vedantjh2/robotic-arm/docs/purchased_hardware_A1.csv

item | quantity | selection_notes
XC330-class compact smart motor | 8 | 20 x 34 x 26 mm verified envelope; final model and duty torque to verify
Matching supplier output horn | 8 | Stock horn plus supplier-matched adapter; CAD bolt pattern provisional
Retained steel finger pin or shoulder bolt 3 mm | 14 | Nominal span 22 mm; determine shoulder and retention lengths
Thumb shoulder axle 5 mm | 1 | Length and washer stack from final thumb assembly
Wrist flexion steel D shaft 5 mm | 1 | Flat at 2 mm from center; nominal modeled span 65 mm; validate hub clamp and retention
Wrist deviation shoulder axle 5 mm | 1 | Nominal modeled span 26 mm; determine thrust washer stack
Wrist flexion bushings 5 mm ID 8 mm OD 8 mm long | 2 | Press/slip fit appropriate to print process; CAD fork bore 8.2 mm
Wrist deviation bushing 5 mm ID 8 mm OD 8 mm long | 1 | Match carpal gimbal bore and shaft fit
Thrust washers and axle keepers | 1 set | Must constrain axial motion without clamping moving parts
M6 cable barrel adjuster with locking nuts | 6 | Finger and thumb-opposition sheath termination on moving palm; confirm ferrule and tube compatibility
Wrist moving-frame sheath ferrules and adjusters | 4 | Two opposed pairs; one set terminates on fixed fork, deviation pair on moving gimbal
Braided UHMWPE tendon approximately 0.8 mm | 1 spool | Supplier load specification knot derating abrasion and creep to validate
PTFE-lined sheath approximately 3 mm OD | 10 runs | 6 hand tendons plus 4 wrist antagonist strands; final ID and bend radius to select
Elastic finger and thumb returns | 15 | 14 flexion joints plus thumb opposition; stiffness and pretension from bench test
Compliant motor seat/shim | 8 | Prevents clamp creep and case damage; verify compressed thickness
M2.5 clamp screws or process-matched inserts | 32 | Sixteen clamps with two screws each; verify modeled post bores
M3 palm/root/anchor/shell fasteners | 1 set | Lengths and captive access to derive from final hardware stack
M4 rail attachment fasteners | 4 | Captive nut or insert detail required for hollow rail ends
M6 proximal mounting fasteners | 4 | Bench fixture and flange load rating to check
M3 shaft set screws | 3 | Two gimbal and one external sector; process-matched threads/inserts and locking method
TPU or silicone contact pads | 5 | Five modeled fingertip pads; optional further phalanx pads
5 V-class regulated motor supply and branch protection | 1 set | XC330 reference is 3.7-6 V recommended 5 V; measured-duty and transient sizing required
TTL motor interface and local controller | 1 set | Deterministic limits current sensing watchdog hard power disconnect; VLM offboard
