vedantjh2/robotic-arm/output/A1/assembly/anatomy_tendon_hand_A1.step

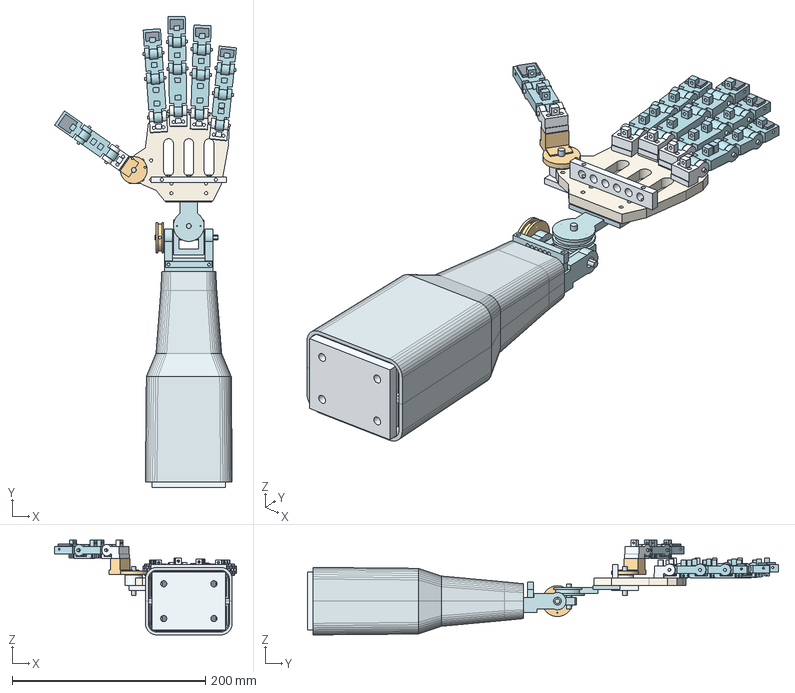
[picture p1: CAD file, 2026-09-28]
output/A1/assembly/anatomy_tendon_hand_A1.step
188.6 x 488.1 x 98.3 mm
Proximal_actuator_cassette
Radius_inspired_rail
Ulna_inspired_rail
Distal_retinaculum
Dorsal_forearm_shell
Palmar_forearm_shell
Radiocarpal_fork
Carpal_gimbal
Wrist_flexion_sector
Carpal_hand_carrier
Metacarpal_frame
Palmar_tendon_anchor
index_root
index_phalanx_1
index_hinge_pin_1
index_phalanx_2
index_hinge_pin_2
index_phalanx_3
index_hinge_pin_3
index_contact_pad
middle_root
middle_phalanx_1
middle_hinge_pin_1
middle_phalanx_2
middle_hinge_pin_2
middle_phalanx_3
middle_hinge_pin_3
middle_contact_pad
ring_root
ring_phalanx_1
ring_hinge_pin_1
ring_phalanx_2
ring_hinge_pin_2
ring_phalanx_3
ring_hinge_pin_3
ring_contact_pad
little_root
little_phalanx_1
little_hinge_pin_1
little_phalanx_2
little_hinge_pin_2
little_phalanx_3
little_hinge_pin_3
little_contact_pad
thumb_root
thumb_phalanx_1
thumb_hinge_pin_1
thumb_phalanx_2
thumb_hinge_pin_2
thumb_contact_pad
Thumb_pivot_housing
Thumb_opposition_carrier
Thumb_pivot_axle
flexion_axle
deviation_axle
Motor_M1
Spool_M1
M1_clamp_-13
M1_clamp_-3
Motor_M2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
