vedantjh2/robotic-arm/output/A1/parts/wrist_flexion_sector.step

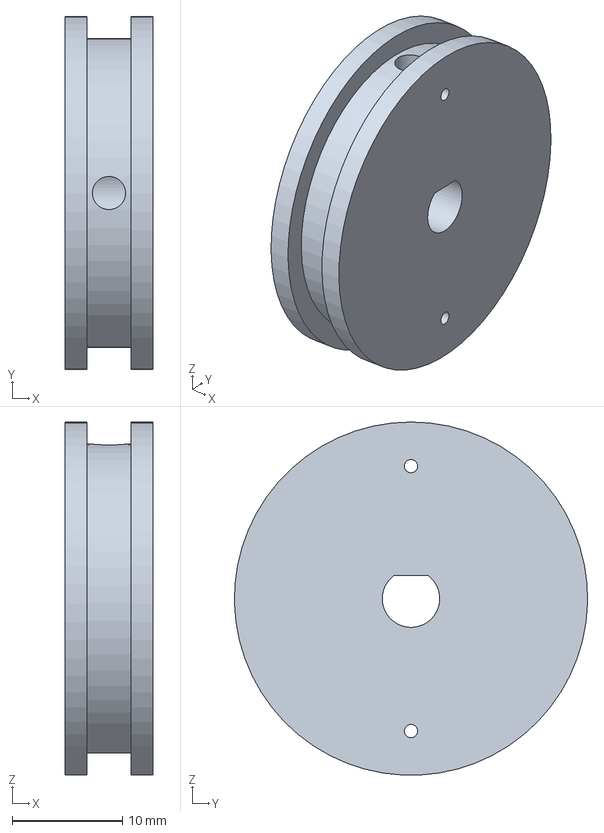
[picture p2: CAD file, 2026-09-28]
output/A1/parts/wrist_flexion_sector.step
8.00 x 32.0 x 32.0 mm
