vedantjh2/robotic-arm/output/assembly/tendon_hand_A0.step

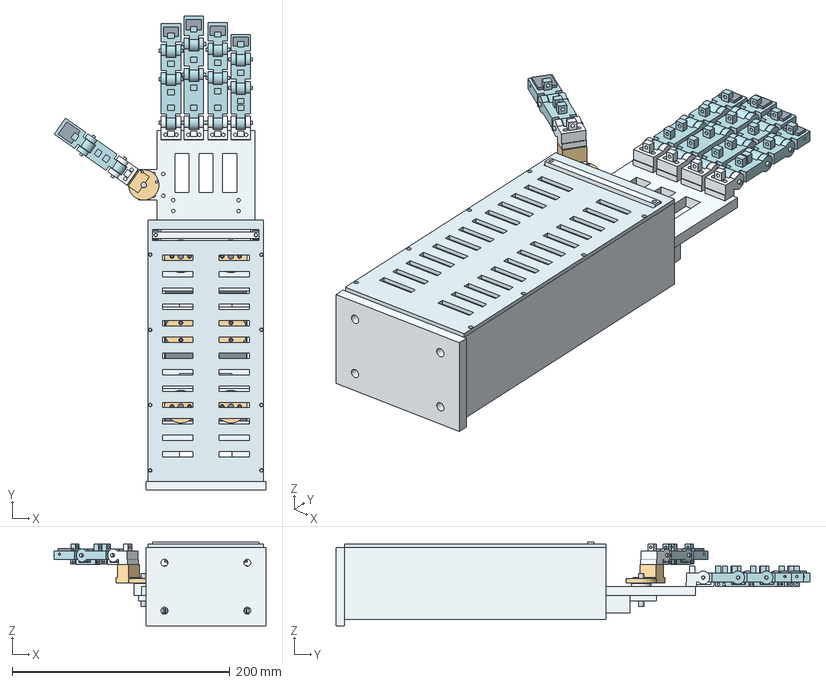
[picture p3: CAD file, 2026-09-28]
output/assembly/tendon_hand_A0.step
194.2 x 435.0 x 77.0 mm
Forearm_chassis
Wrist_bridge
Palm_frame
Forearm_cover
Sheath_comb_1
Sheath_comb_2
Adjustable_sheath_anchor
Motor_M1
Spool_M1
M1_clamp_-18
M1_clamp_-6
Motor_M2
Spool_M2
M2_clamp_-18
M2_clamp_-6
Motor_M3
Spool_M3
M3_clamp_-18
M3_clamp_-6
Motor_M4
Spool_M4
M4_clamp_-18
M4_clamp_-6
Motor_M5
Spool_M5
M5_clamp_-18
M5_clamp_-6
Motor_M6
Spool_M6
M6_clamp_-18
M6_clamp_-6
index_root
index_phalanx_1
index_hinge_pin_1
index_phalanx_2
index_hinge_pin_2
index_phalanx_3
index_hinge_pin_3
index_contact_pad
middle_root
middle_phalanx_1
middle_hinge_pin_1
middle_phalanx_2
middle_hinge_pin_2
middle_phalanx_3
middle_hinge_pin_3
middle_contact_pad
ring_root
ring_phalanx_1
ring_hinge_pin_1
ring_phalanx_2
ring_hinge_pin_2
ring_phalanx_3
ring_hinge_pin_3
ring_contact_pad
little_root
little_phalanx_1
little_hinge_pin_1
little_phalanx_2
little_hinge_pin_2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
