vedantjh2/robotic-arm/output/parts/bowden_anchor.step

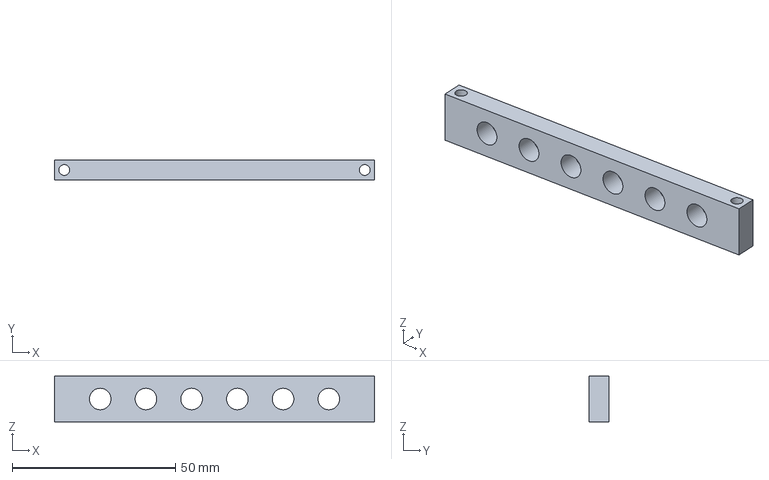
[picture p4: CAD file, 2026-09-28]
output/parts/bowden_anchor.step
98.0 x 6.00 x 14.0 mm
