vedantjh2/robotic-arm/output/A1/parts/index_3.step

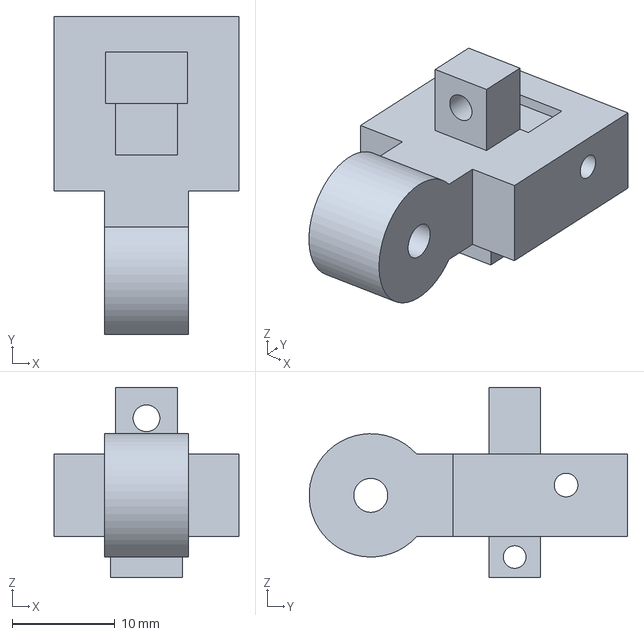
[picture p5: CAD file, 2026-09-28]
output/A1/parts/index_3.step
18.0 x 31.0 x 18.5 mm
