vedantjh2/robotic-arm/output/parts/palm_frame.step

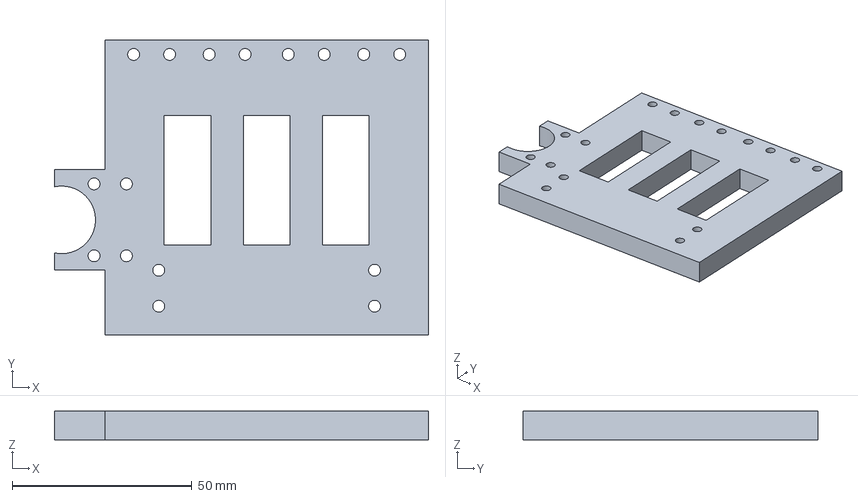
[picture p6: CAD file, 2026-09-28]
output/parts/palm_frame.step
104.0 x 82.0 x 8.00 mm
