vedantjh2/robotic-arm/output/A1/parts/index_1.step

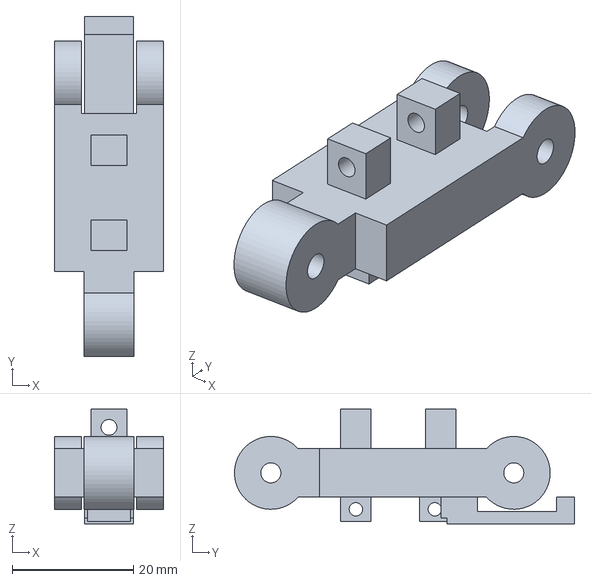
[picture p7: CAD file, 2026-09-28]
output/A1/parts/index_1.step
18.0 x 56.0 x 18.9 mm
