vedantjh2/robotic-arm/output/parts/ring_2.step

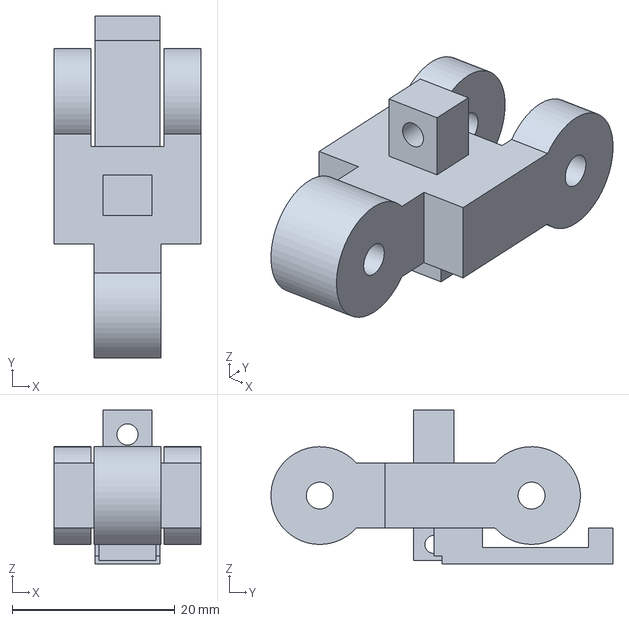
[picture p8: CAD file, 2026-09-28]
output/parts/ring_2.step
18.0 x 42.0 x 18.9 mm
