vedantjh2/robotic-arm/output/A1/parts/thumb_1.step

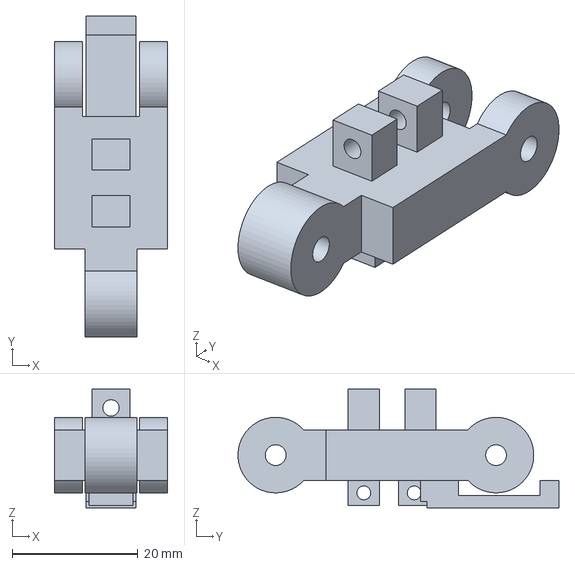
[picture p9: CAD file, 2026-09-28]
output/A1/parts/thumb_1.step
18.0 x 51.0 x 18.9 mm
