vedantjh2/robotic-arm/output/parts/fit_coupon.step

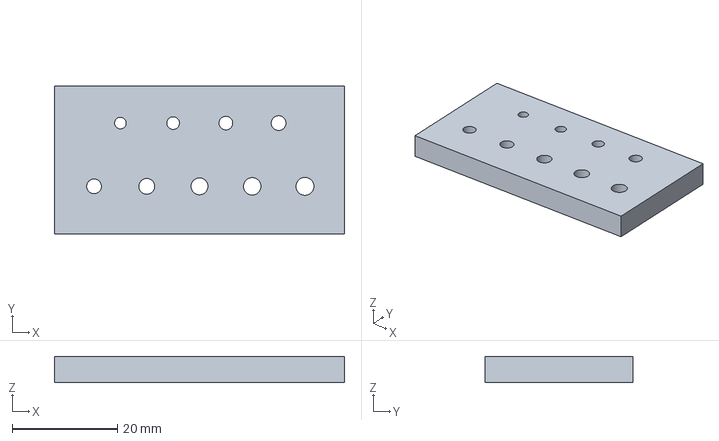
[picture p10: CAD file, 2026-09-28]
output/parts/fit_coupon.step
55.0 x 28.0 x 5.00 mm
