vedantjh2/robotic-arm/output/A1/parts/tendon_retinaculum.step

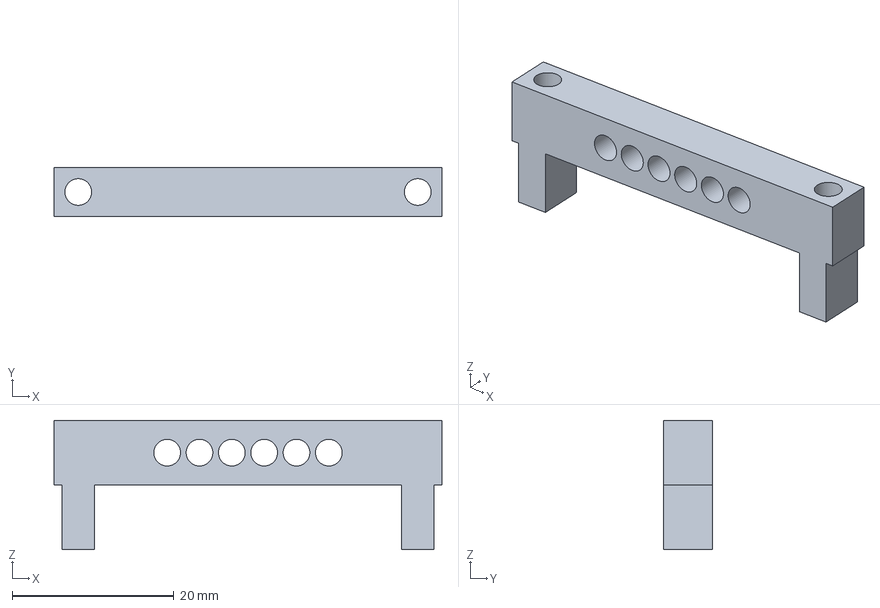
[picture p11: CAD file, 2026-09-28]
output/A1/parts/tendon_retinaculum.step
48.0 x 6.00 x 16.0 mm
