vedantjh2/robotic-arm/output/parts/little_pad.step

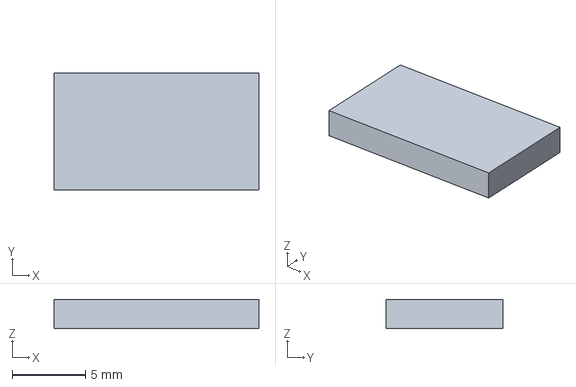
[picture p12: CAD file, 2026-09-28]
output/parts/little_pad.step
14.0 x 8.00 x 2.00 mm
