vedantjh2/robotic-arm/output/A1/parts/palmar_shell.step

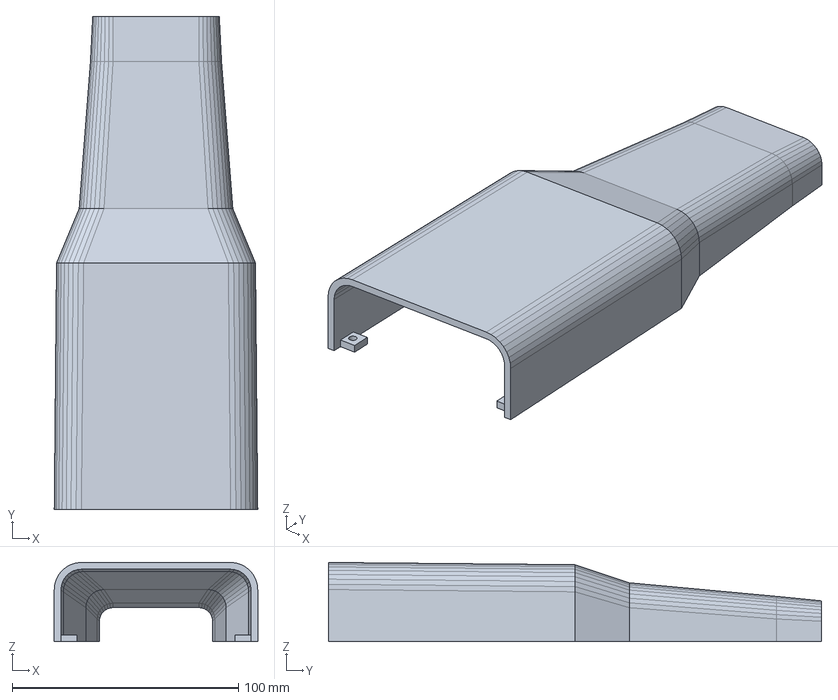
[picture p13: CAD file, 2026-09-28]
output/A1/parts/palmar_shell.step
90.0 x 218.0 x 35.0 mm
