vedantjh2/robotic-arm/output/parts/little_3.step

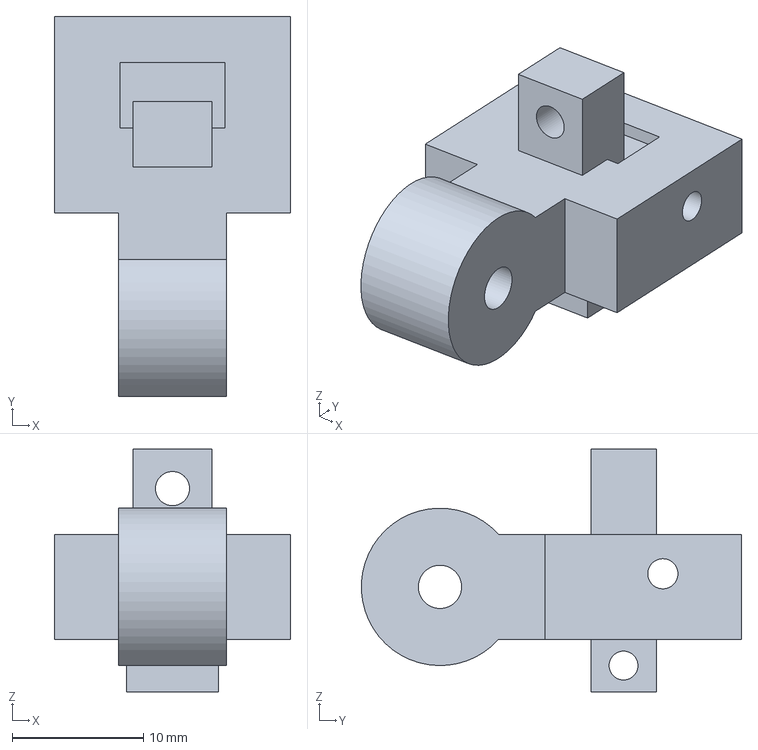
[picture p14: CAD file, 2026-09-28]
output/parts/little_3.step
18.0 x 29.0 x 18.5 mm
