vedantjh2/robotic-arm/output/parts/middle_3.step

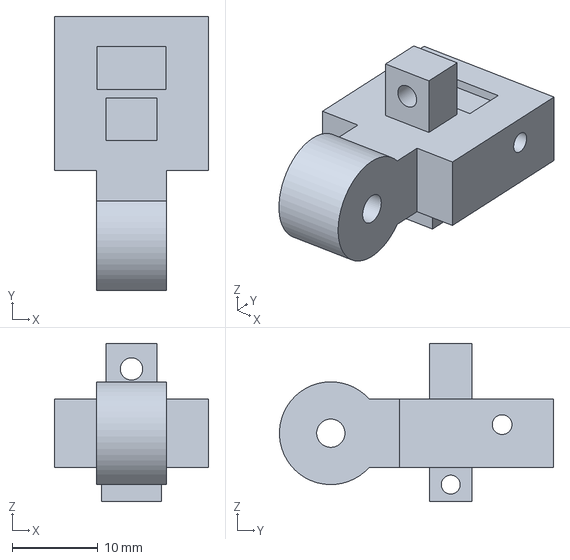
[picture p15: CAD file, 2026-09-28]
output/parts/middle_3.step
18.0 x 32.0 x 18.5 mm
