vedantjh2/robotic-arm/output/A1/parts/metacarpal_frame.step

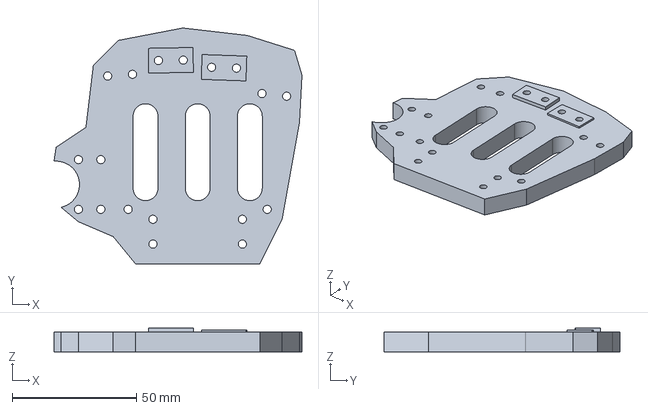
[picture p16: CAD file, 2026-09-28]
output/A1/parts/metacarpal_frame.step
99.8 x 95.0 x 9.60 mm
