vedantjh2/robotic-arm/output/parts/middle_1.step

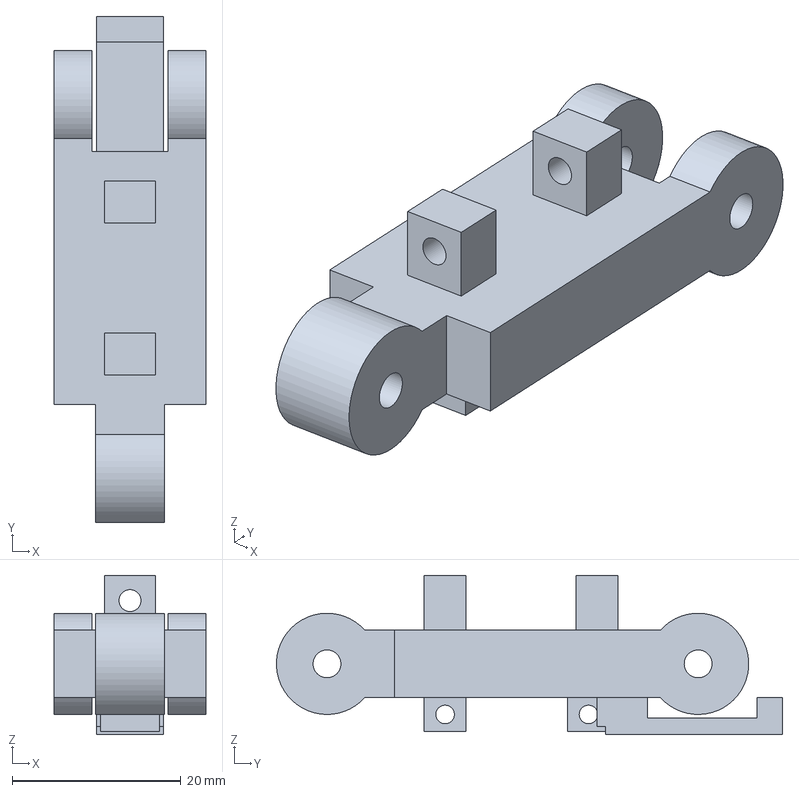
[picture p17: CAD file, 2026-09-28]
output/parts/middle_1.step
18.0 x 60.0 x 18.9 mm
