vedantjh2/robotic-arm/output/A1/parts/ulna_rail.step

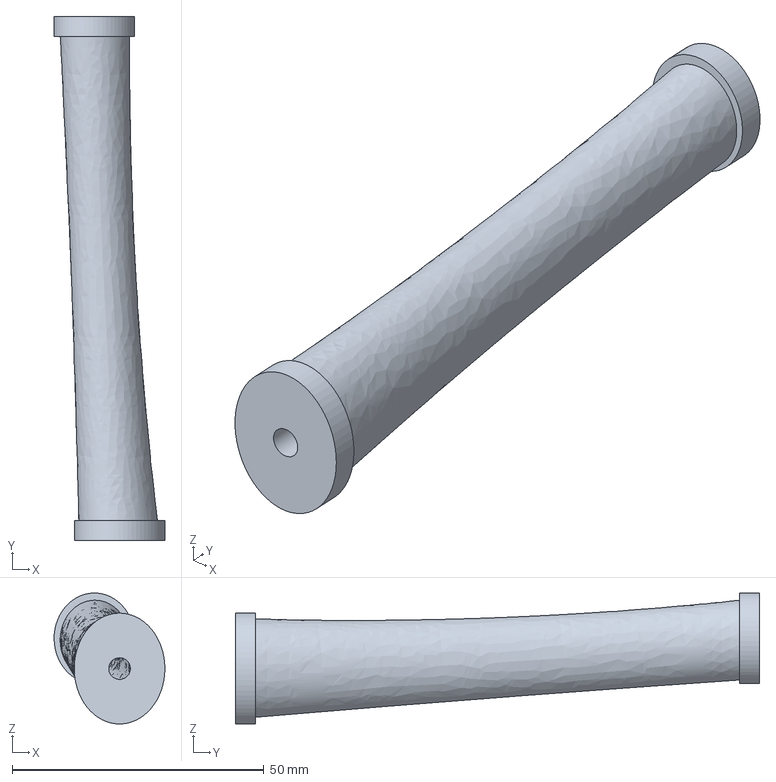
[picture p18: CAD file, 2026-09-28]
output/A1/parts/ulna_rail.step
22.0 x 104.0 x 26.0 mm
