vedantjh2/robotic-arm/output/parts/thumb_2.step

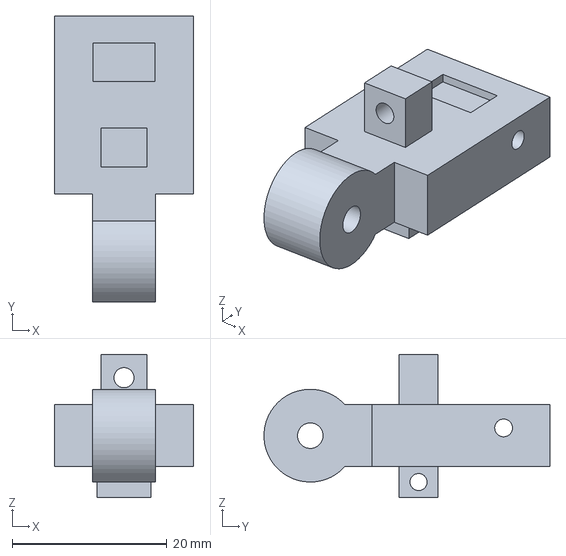
[picture p19: CAD file, 2026-09-28]
output/parts/thumb_2.step
18.0 x 37.0 x 18.5 mm
