vedantjh2/robotic-arm/output/A1/parts/index_pad.step

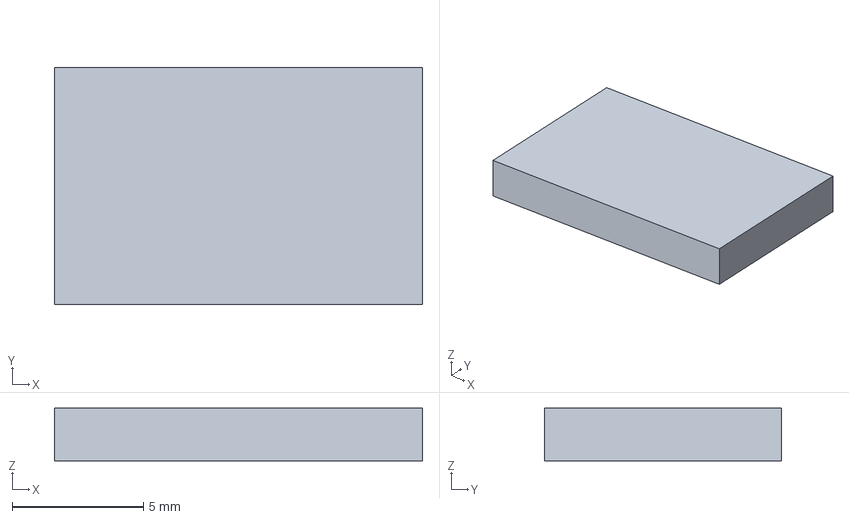
[picture p20: CAD file, 2026-09-28]
output/A1/parts/index_pad.step
14.0 x 9.00 x 2.00 mm
