vedantjh2/robotic-arm/output/parts/bowden_comb.step

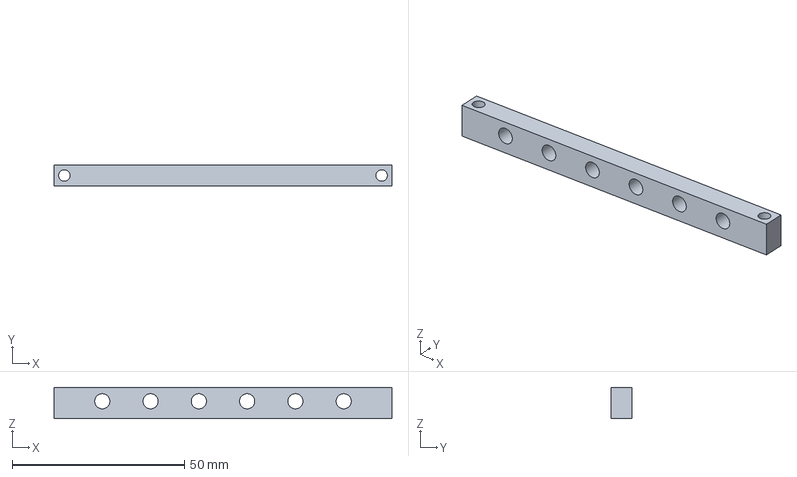
[picture p21: CAD file, 2026-09-28]
output/parts/bowden_comb.step
98.0 x 6.00 x 9.00 mm
