vedantjh2/robotic-arm/output/parts/thumb_opposition_carrier.step

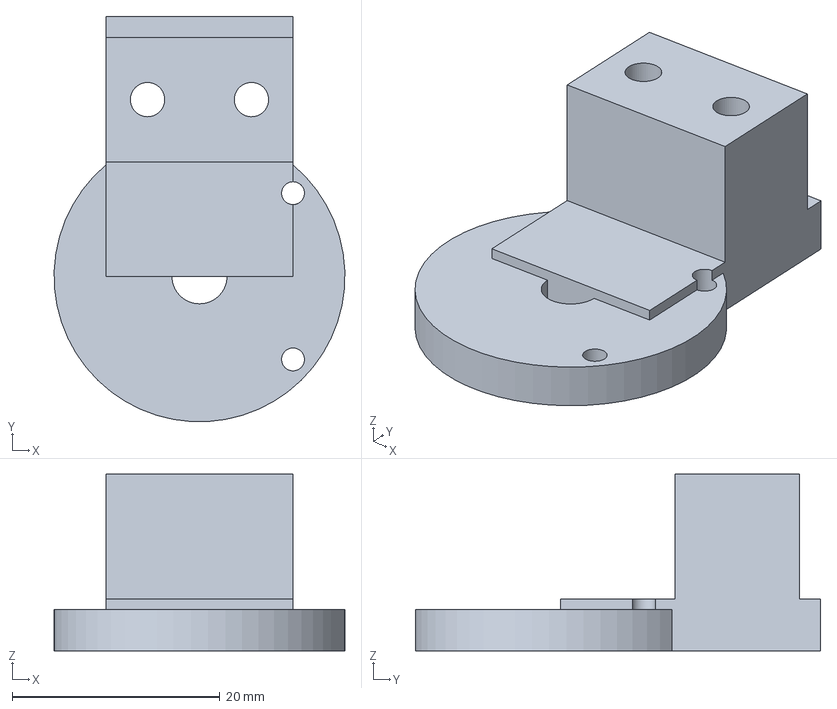
[picture p22: CAD file, 2026-09-28]
output/parts/thumb_opposition_carrier.step
28.0 x 39.0 x 17.0 mm
