vedantjh2/robotic-arm/output/A1/parts/micro_servo_clamp.step

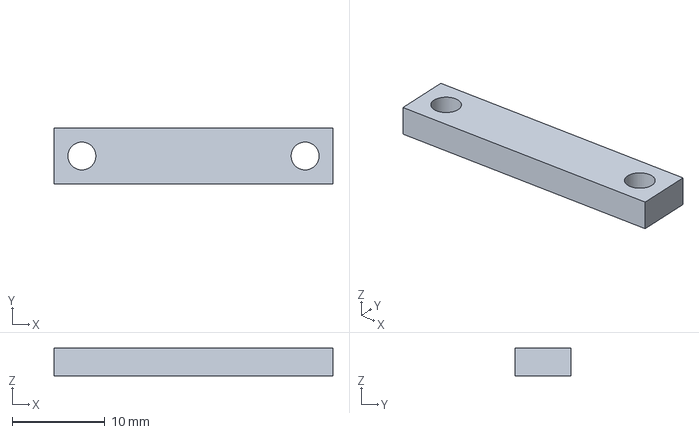
[picture p23: CAD file, 2026-09-28]
output/A1/parts/micro_servo_clamp.step
30.0 x 6.00 x 3.00 mm
