vedantjh2/robotic-arm/output/parts/motor_clamp.step

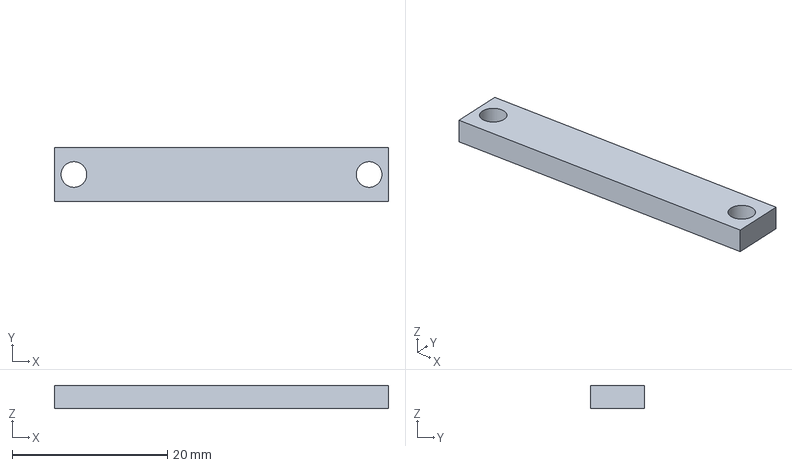
[picture p24: CAD file, 2026-09-28]
output/parts/motor_clamp.step
43.0 x 7.00 x 3.00 mm
