vedantjh2/robotic-arm/output/parts/middle_2.step

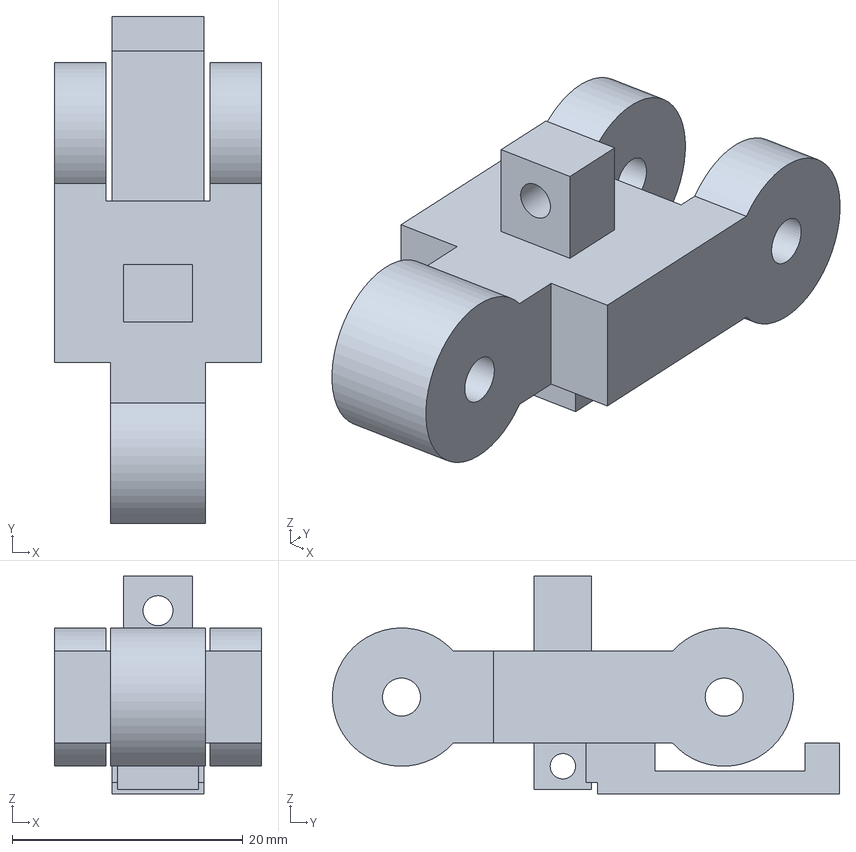
[picture p25: CAD file, 2026-09-28]
output/parts/middle_2.step
18.0 x 44.0 x 18.9 mm
