vedantjh2/robotic-arm/output/A1/parts/middle_pad.step

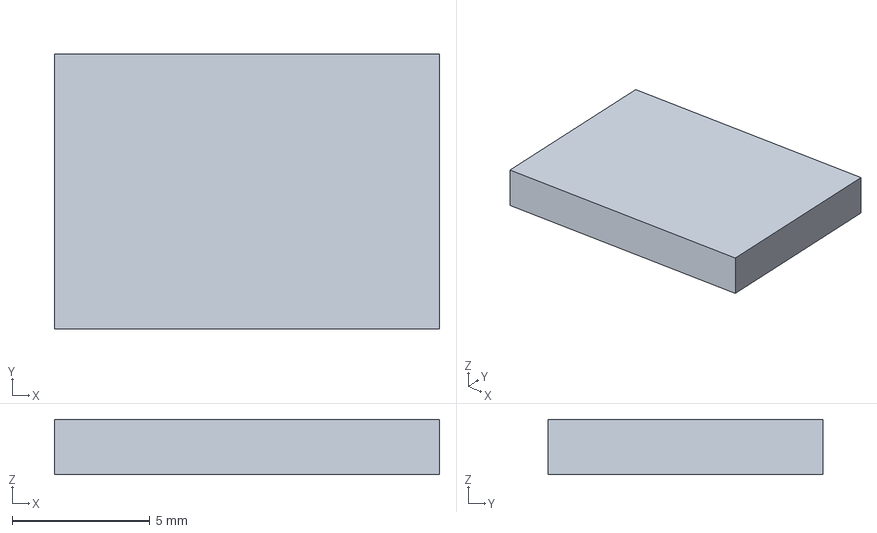
[picture p26: CAD file, 2026-09-28]
output/A1/parts/middle_pad.step
14.0 x 10.0 x 2.00 mm
