vedantjh2/robotic-arm/output/parts/ring_1.step

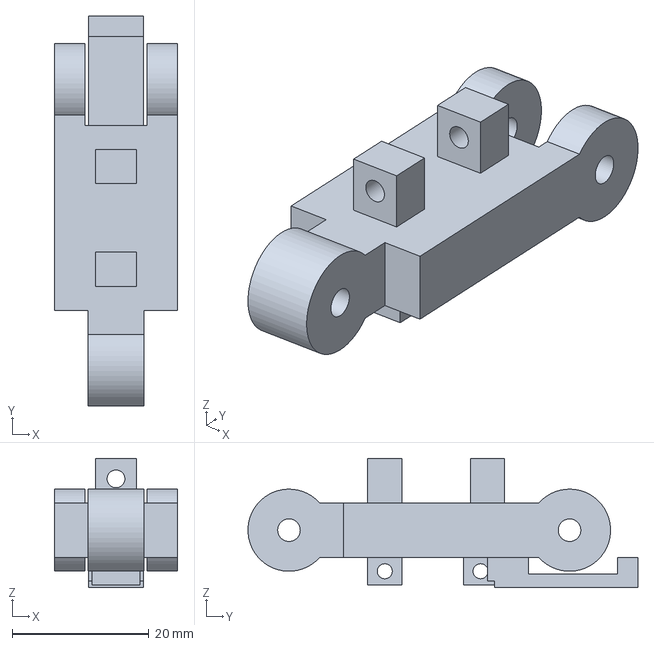
[picture p27: CAD file, 2026-09-28]
output/parts/ring_1.step
18.0 x 57.0 x 18.9 mm
