vedantjh2/robotic-arm/output/parts/tendon_spool.step

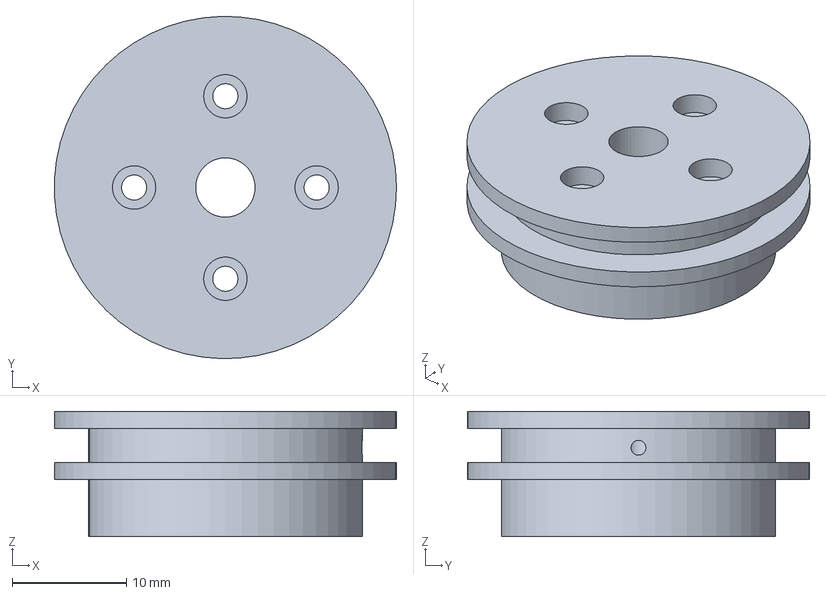
[picture p29: CAD file, 2026-09-28]
output/parts/tendon_spool.step
30.0 x 30.0 x 11.0 mm
