vedantjh2/robotic-arm/output/parts/forearm_cover.step

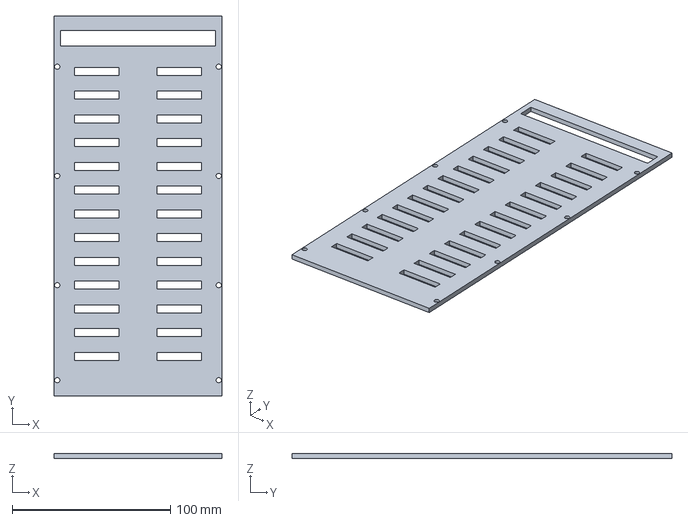
[picture p30: CAD file, 2026-09-28]
output/parts/forearm_cover.step
106.0 x 240.0 x 3.00 mm
