vedantjh2/robotic-arm/output/A1/parts/carpal_hand_carrier.step

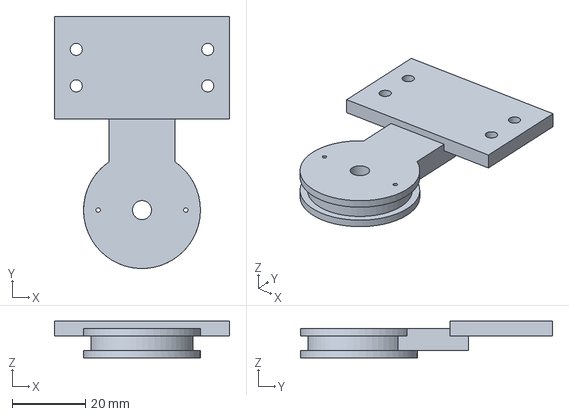
[picture p31: CAD file, 2026-09-28]
output/A1/parts/carpal_hand_carrier.step
48.0 x 69.0 x 10.0 mm
