vedantjh2/robotic-arm/output/parts/forearm_chassis.step

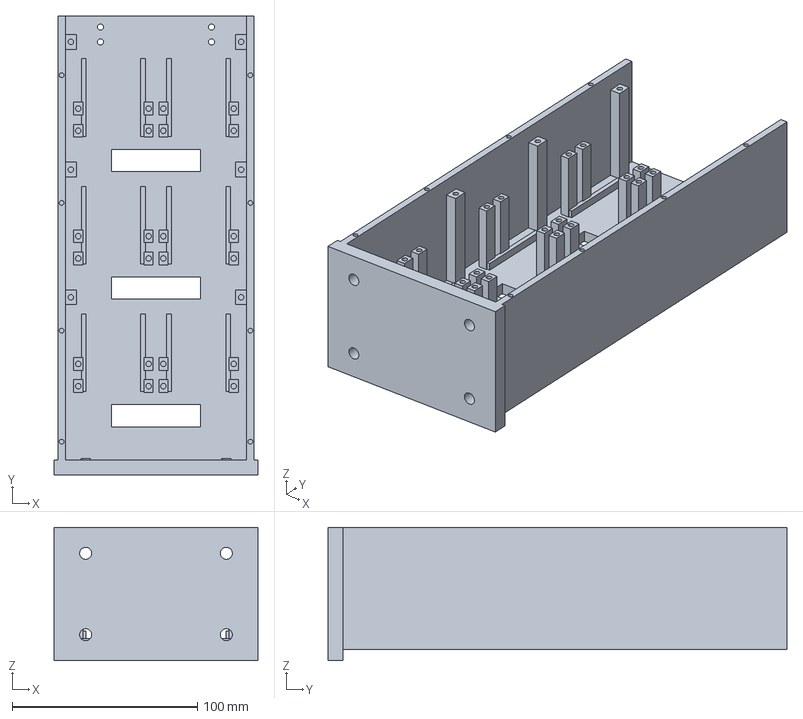
[picture p32: CAD file, 2026-09-28]
output/parts/forearm_chassis.step
110.0 x 248.0 x 72.0 mm
