vedantjh2/robotic-arm/output/A1/parts/proximal_motor_cassette.step

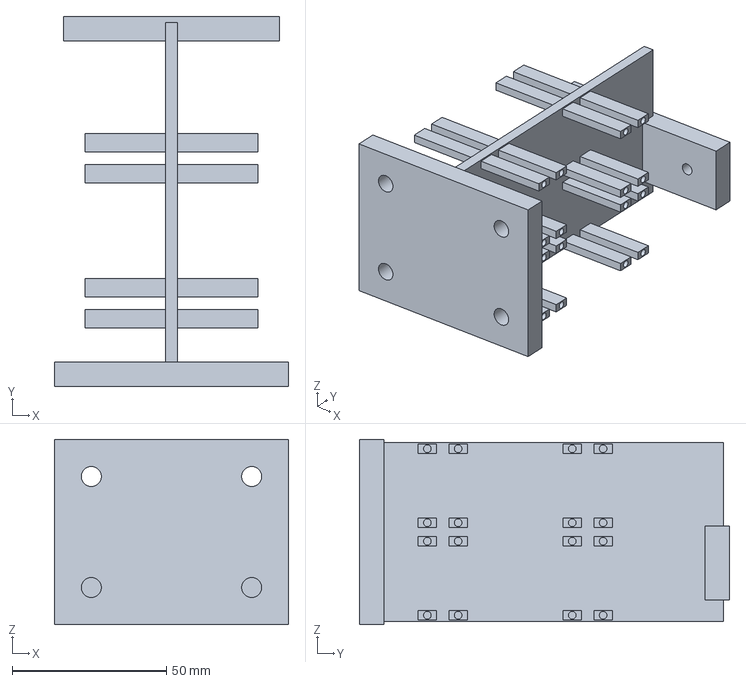
[picture p33: CAD file, 2026-09-28]
output/A1/parts/proximal_motor_cassette.step
76.0 x 120.0 x 60.0 mm
