vedantjh2/robotic-arm/output/parts/thumb_pivot_base.step

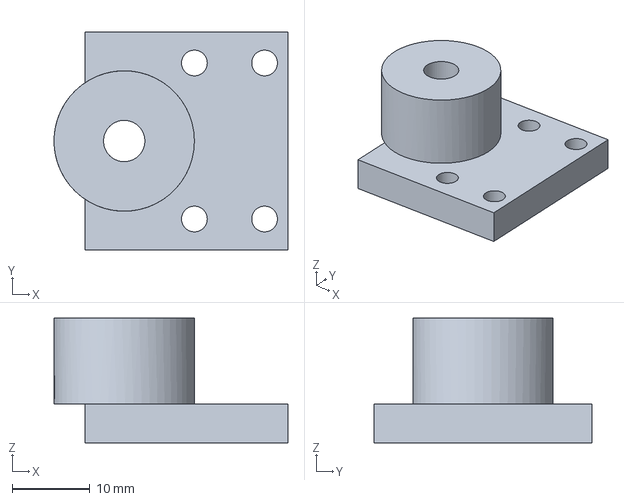
[picture p34: CAD file, 2026-09-28]
output/parts/thumb_pivot_base.step
30.0 x 28.0 x 16.0 mm
