vedantjh2/robotic-arm/output/parts/thumb_pad.step

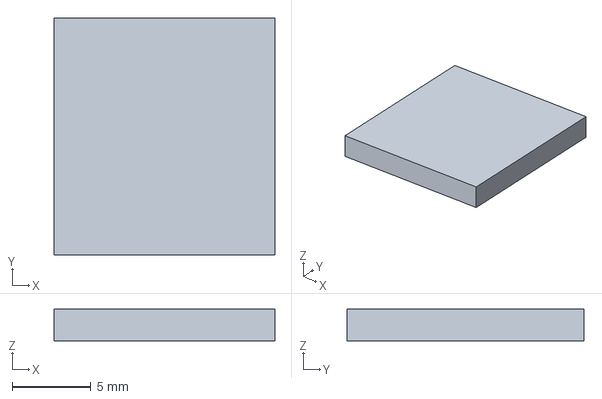
[picture p35: CAD file, 2026-09-28]
output/parts/thumb_pad.step
14.0 x 15.0 x 2.00 mm
