vedantjh2/robotic-arm/output/A1/parts/mcp_root.step

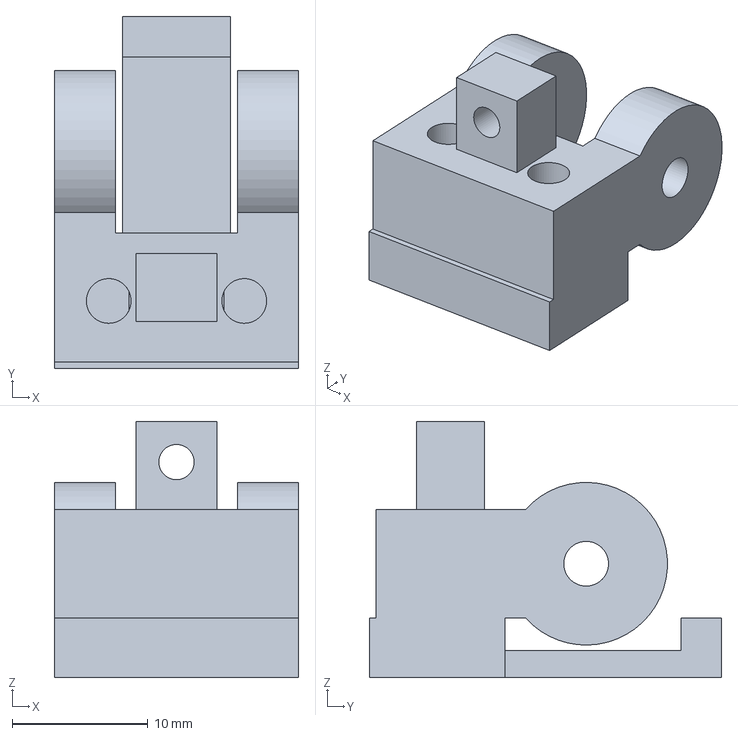
[picture p36: CAD file, 2026-09-28]
output/A1/parts/mcp_root.step
18.0 x 26.0 x 18.9 mm
