vedantjh2/robotic-arm/output/parts/fixed_wrist_bridge.step

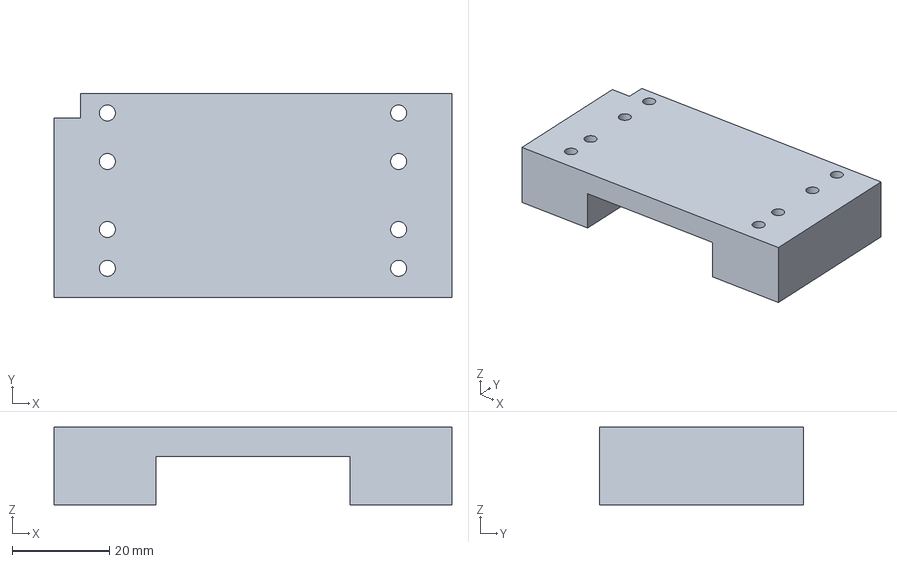
[picture p37: CAD file, 2026-09-28]
output/parts/fixed_wrist_bridge.step
82.0 x 42.0 x 16.0 mm
