vedantjh2/robotic-arm/output/A1/parts/micro_tendon_spool.step

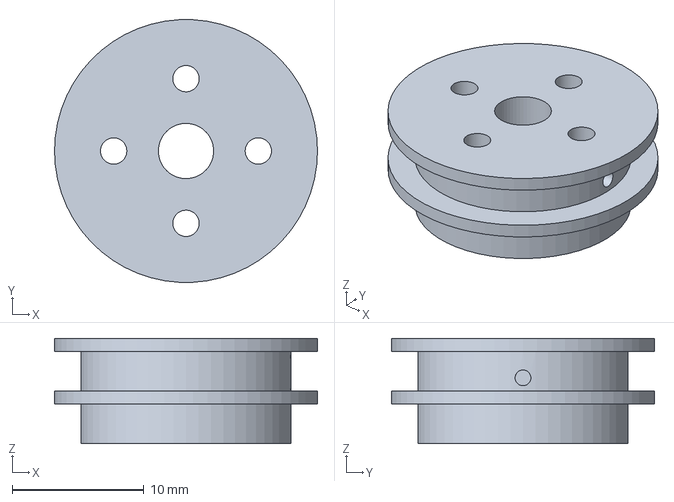
[picture p39: CAD file, 2026-09-28]
output/A1/parts/micro_tendon_spool.step
20.0 x 20.0 x 8.00 mm
