vedantjh2/robotic-arm/output/A1/parts/palmar_bowden_anchor.step

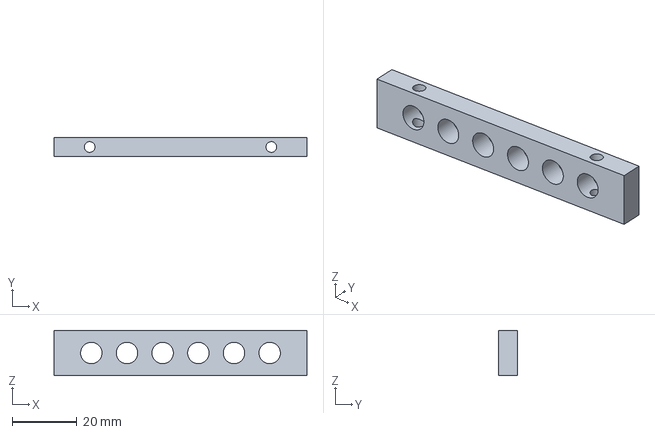
[picture p40: CAD file, 2026-09-28]
output/A1/parts/palmar_bowden_anchor.step
78.0 x 6.00 x 14.0 mm
