vedantjh2/robotic-arm/output/A1/parts/radiocarpal_fork.step

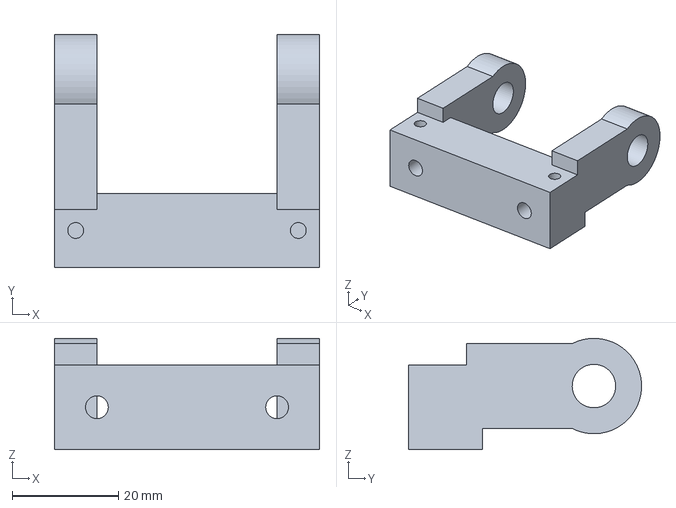
[picture p41: CAD file, 2026-09-28]
output/A1/parts/radiocarpal_fork.step
50.0 x 44.0 x 21.0 mm
