vedantjh2/robotic-arm/output/A1/parts/carpal_gimbal.step

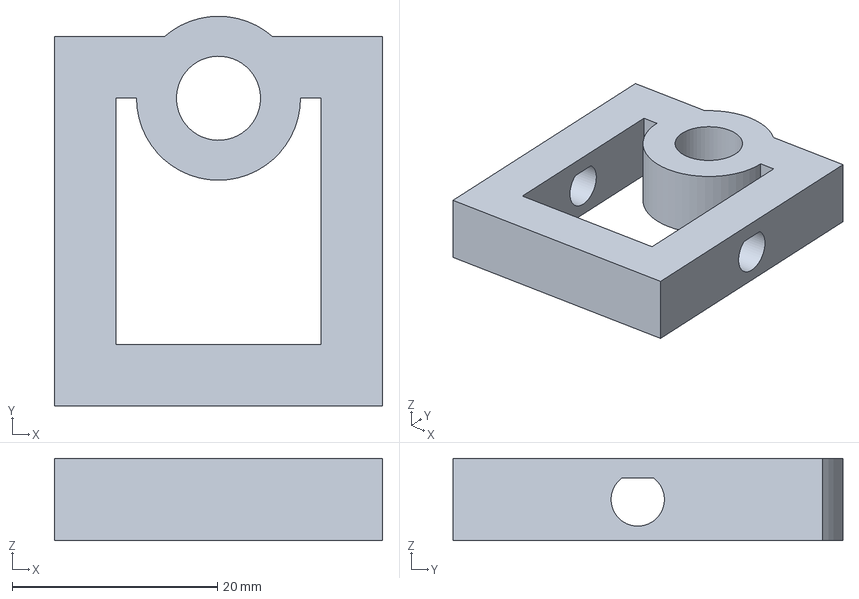
[picture p42: CAD file, 2026-09-28]
output/A1/parts/carpal_gimbal.step
32.0 x 38.0 x 8.00 mm
