vedantjh2/robotic-arm/(list of files, cad)

Other CAD files:
output/A1/parts/dorsal_shell.step
output/A1/parts/middle_3.step
output/parts/thumb_1.step
output/A1/parts/little_pad.step
output/A1/parts/thumb_opposition_carrier.step
output/parts/index_pad.step
output/A1/parts/radius_rail.step
output/A1/parts/little_3.step
output/parts/index_1.step
output/A1/parts/ring_pad.step
output/parts/ring_pad.step
output/A1/parts/middle_2.step
output/A1/parts/middle_1.step
output/parts/ring_3.step
output/A1/parts/thumb_2.step
output/A1/parts/ring_2.step
output/parts/index_3.step
output/parts/little_1.step
output/A1/parts/thumb_pivot_base.step
output/parts/middle_pad.step
output/A1/parts/thumb_pad.step
output/parts/mcp_root.step
output/A1/parts/index_2.step
output/parts/index_2.step
output/parts/little_2.step
output/A1/parts/ring_3.step
output/A1/parts/little_2.step
output/A1/parts/ring_1.step
output/A1/parts/carpal_gimbal.stl
output/A1/parts/carpal_hand_carrier.stl
output/A1/parts/dorsal_shell.stl
output/A1/parts/index_1.stl
output/A1/parts/index_2.stl
output/A1/parts/index_3.stl
output/A1/parts/index_pad.stl
output/A1/parts/little_1.stl
output/A1/parts/little_2.stl
output/A1/parts/little_3.stl
output/A1/parts/little_pad.stl
output/A1/parts/mcp_root.stl
output/A1/parts/metacarpal_frame.stl
output/A1/parts/micro_servo_clamp.stl
output/A1/parts/micro_tendon_spool.stl
output/A1/parts/middle_1.stl
output/A1/parts/middle_2.stl
output/A1/parts/middle_3.stl
output/A1/parts/middle_pad.stl
output/A1/parts/palmar_bowden_anchor.stl
output/A1/parts/palmar_shell.stl
output/A1/parts/proximal_motor_cassette.stl
output/A1/parts/radiocarpal_fork.stl
output/A1/parts/radius_rail.stl
output/A1/parts/ring_1.stl
output/A1/parts/ring_2.stl
output/A1/parts/ring_3.stl
output/A1/parts/ring_pad.stl
output/A1/parts/tendon_retinaculum.stl
output/A1/parts/thumb_1.stl
output/A1/parts/thumb_2.stl
output/A1/parts/thumb_opposition_carrier.stl
output/A1/parts/thumb_pad.stl
output/A1/parts/thumb_pivot_base.stl
output/A1/parts/ulna_rail.stl
output/A1/parts/wrist_dual_spool.stl
output/A1/parts/wrist_flexion_sector.stl
output/parts/bowden_anchor.stl
output/parts/bowden_comb.stl
output/parts/fit_coupon.stl
output/parts/fixed_wrist_bridge.stl
output/parts/forearm_chassis.stl
output/parts/forearm_cover.stl
output/parts/index_1.stl
output/parts/index_2.stl
output/parts/index_3.stl
output/parts/index_pad.stl
output/parts/little_1.stl
output/parts/little_2.stl
output/parts/little_3.stl
output/parts/little_pad.stl
output/parts/mcp_root.stl
output/parts/middle_1.stl
output/parts/middle_2.stl
output/parts/middle_3.stl
output/parts/middle_pad.stl
output/parts/motor_clamp.stl
output/parts/palm_frame.stl
output/parts/ring_1.stl
output/parts/ring_2.stl
output/parts/ring_3.stl
output/parts/ring_pad.stl
output/parts/tendon_spool.stl
output/parts/thumb_1.stl
output/parts/thumb_2.stl
output/parts/thumb_opposition_carrier.stl
output/parts/thumb_pad.stl
output/parts/thumb_pivot_base.stl
