vedantjh2/robotic-arm/output/A1/assembly/anatomy_preview.png

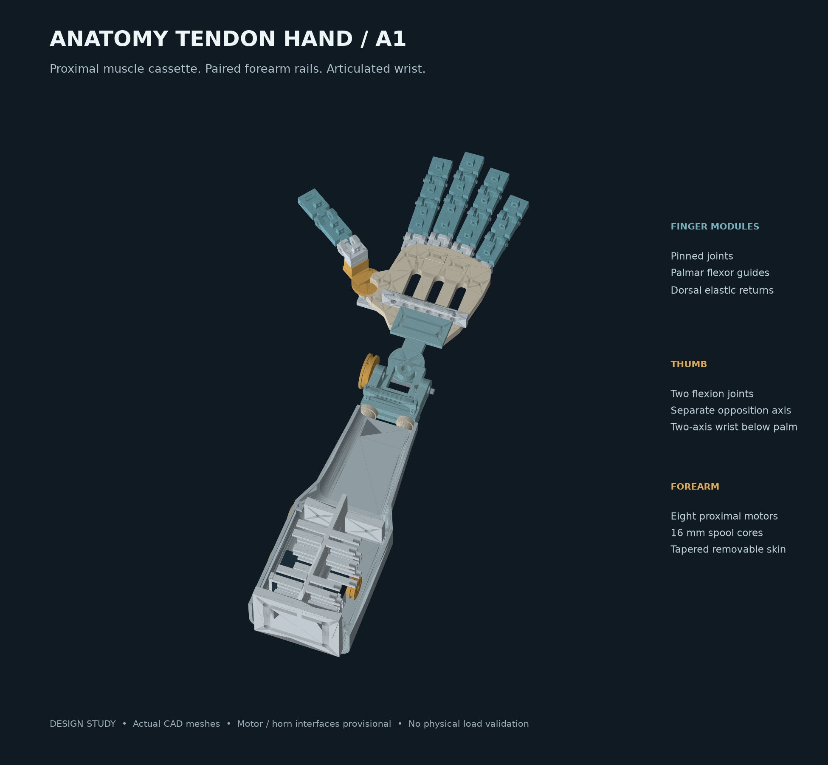
output/A1/assembly/anatomy_preview.png
