vedantjh2/robotic-arm/(commit log)

2026-09-28 Add anatomy-inspired tendon hand CAD with proximal motors and articulated wrist
    [anatomy_tendon_hand_A1.step, bowden_anchor.step, bowden_anchor.stl, bowden_comb.step, bowden_comb.stl, carpal_gimbal.step, carpal_gimbal.stl, carpal_hand_carrier.step]
2026-09-28 Configure binary CAD exports and consistent manifest formatting
    [parts_manifest.csv]
2026-09-28 Improve CAD preview rendering and annotation layout
